AaronXu07/2023-WRO-Future-Engineers-Competition/v-photos/RightSideInternalComponents.jpg

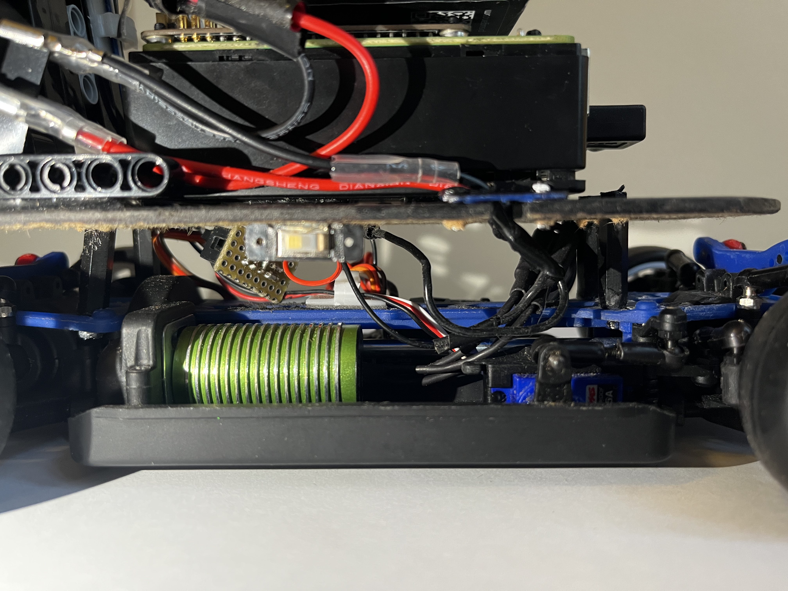
v-photos/RightSideInternalComponents.jpg
