AaronXu07/2023-WRO-Future-Engineers-Competition/v-photos/LeftSideInternalComponents.jpg

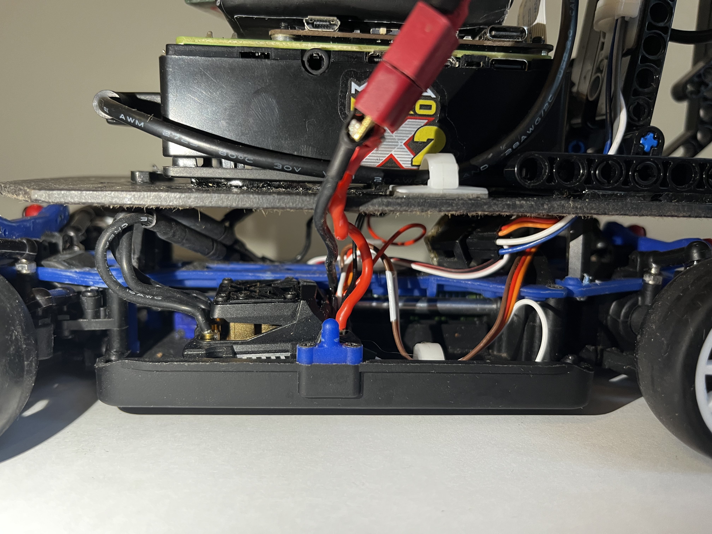
v-photos/LeftSideInternalComponents.jpg
