AaronXu07/2023-WRO-Future-Engineers-Competition/schemes/FutureEngineersWRO2023Schematic.png

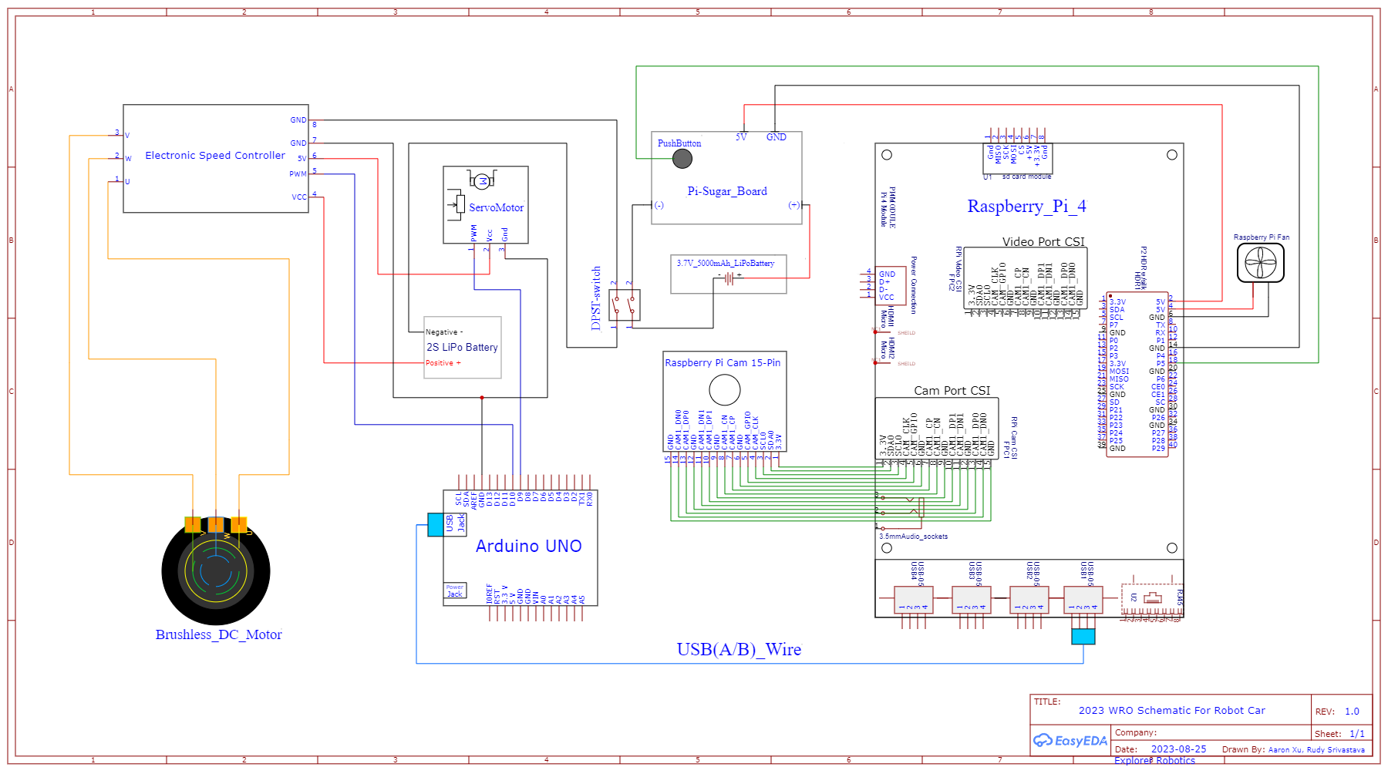
schemes/FutureEngineersWRO2023Schematic.png
