AaronXu07/2023-WRO-Future-Engineers-Competition/t-photos/OfficialTeamPhoto.jpg

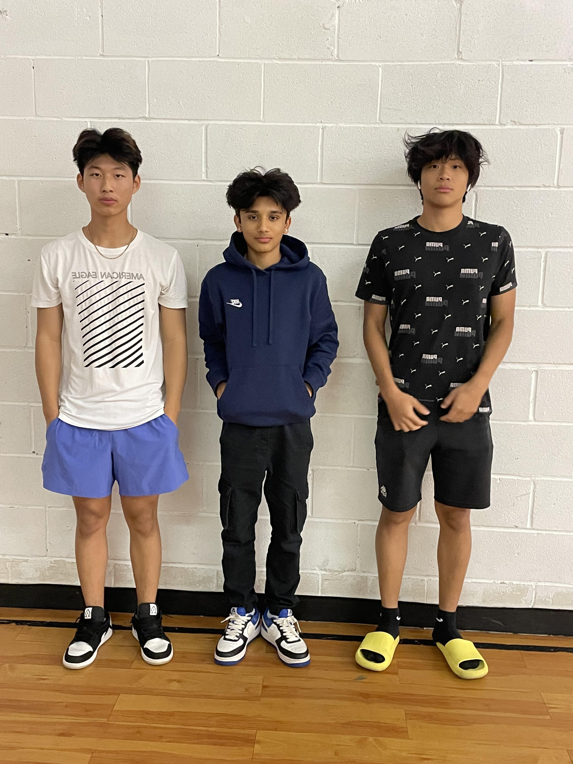
t-photos/OfficialTeamPhoto.jpg
