AaronXu07/2023-WRO-Future-Engineers-Competition/t-photos/SillyPic.jpg

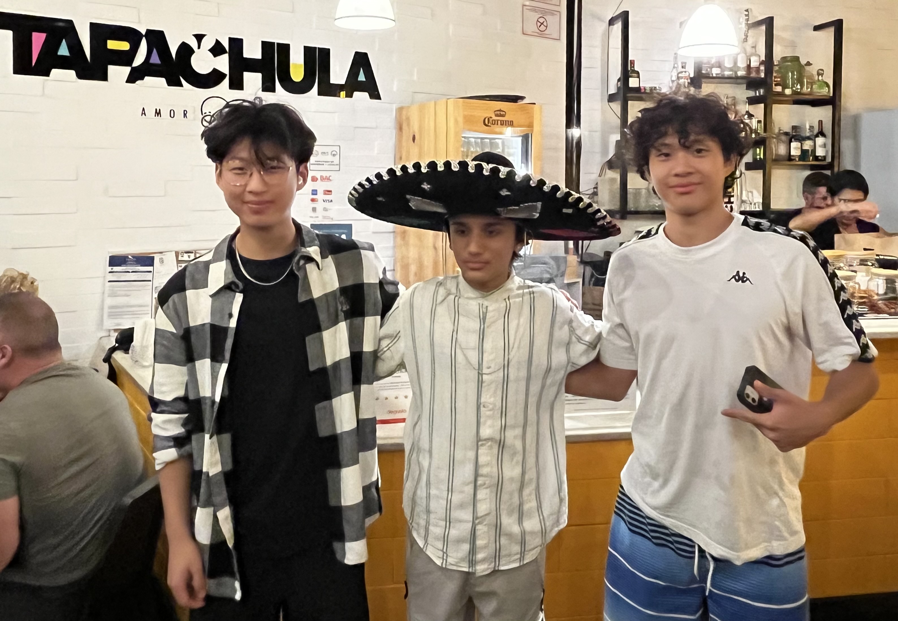
t-photos/SillyPic.jpg
