AaronXu07/2023-WRO-Future-Engineers-Competition/v-photos/Model2BottomView.jpg

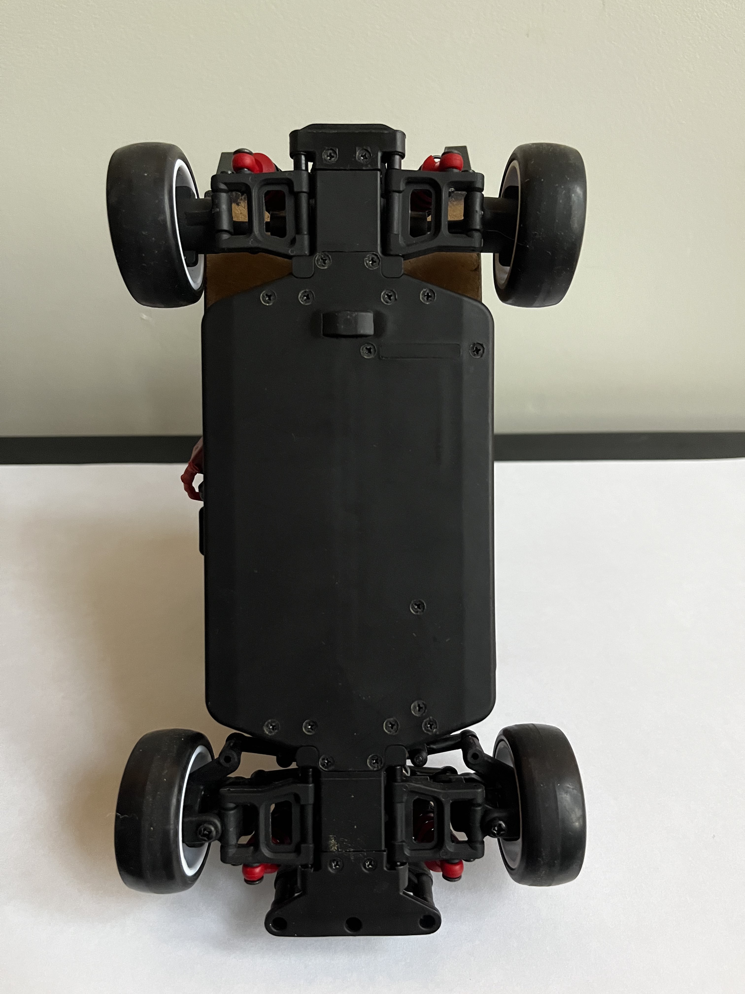
v-photos/Model2BottomView.jpg
