AaronXu07/2023-WRO-Future-Engineers-Competition/v-photos/Model2FrontView.jpg

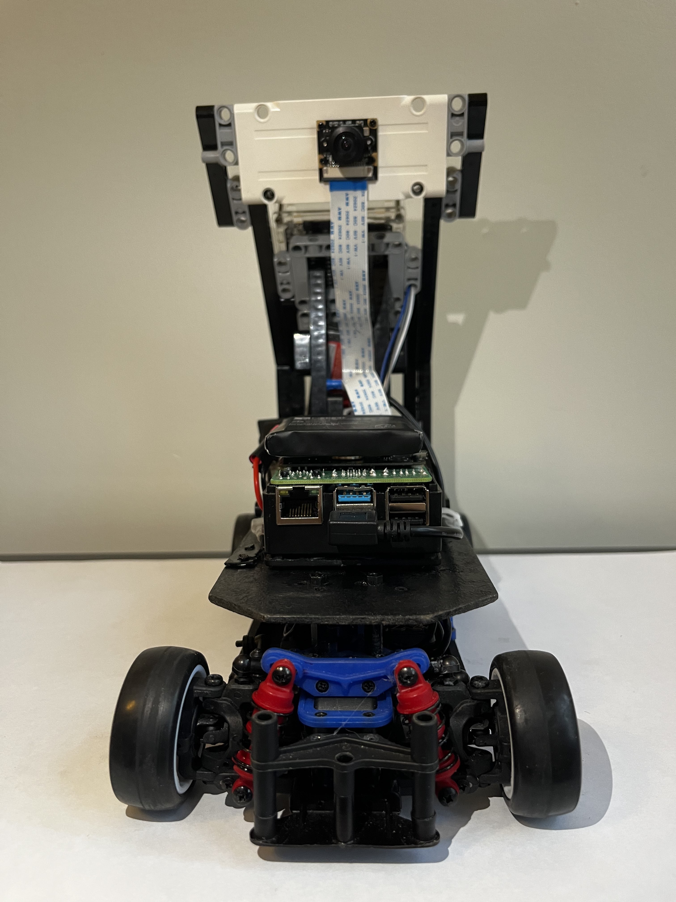
v-photos/Model2FrontView.jpg
