AaronXu07/2023-WRO-Future-Engineers-Competition/v-photos/Model2LeftView.jpg

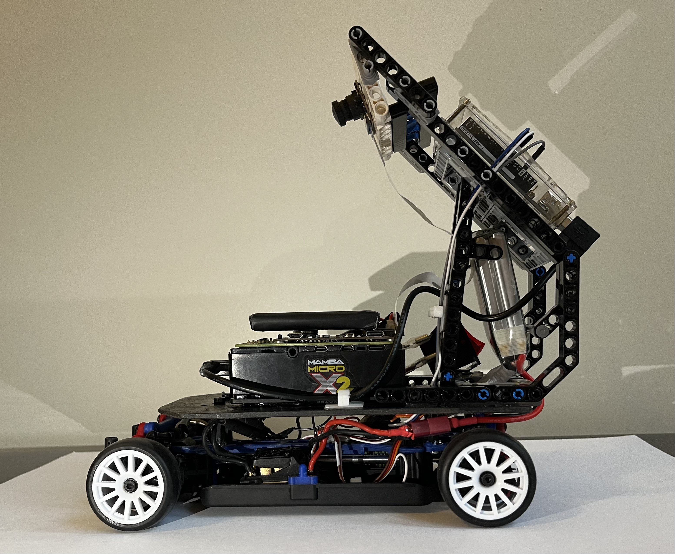
v-photos/Model2LeftView.jpg
