AaronXu07/2023-WRO-Future-Engineers-Competition/v-photos/Model2TopView.jpg

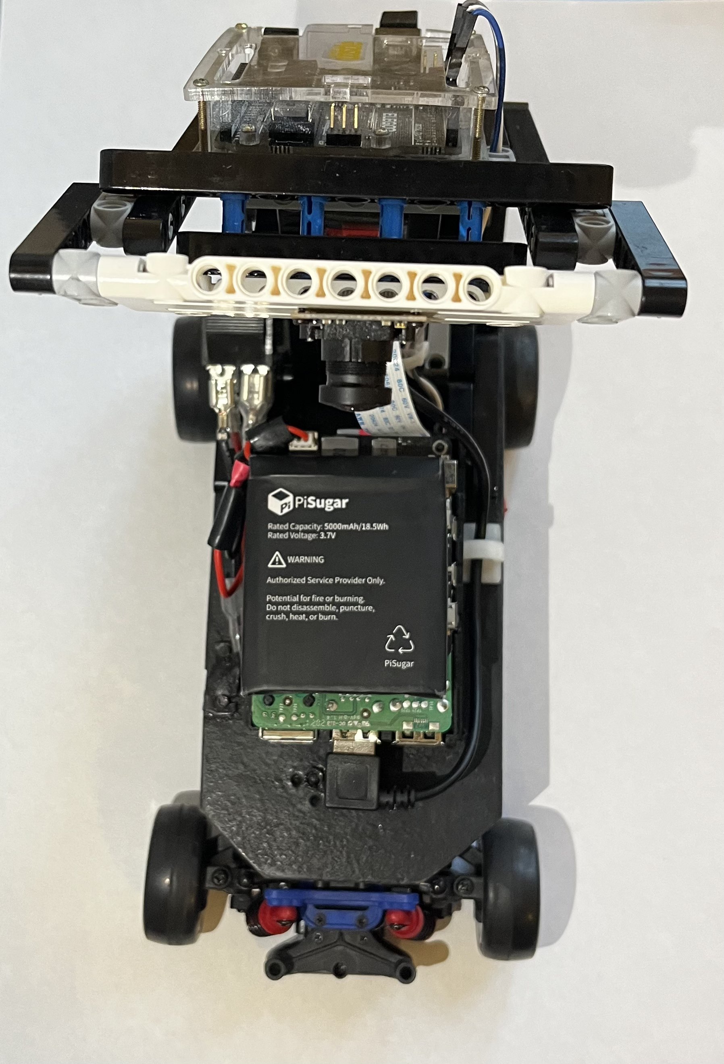
v-photos/Model2TopView.jpg
