AaronXu07/2023-WRO-Future-Engineers-Competition/v-photos/ModelComparison.jpg

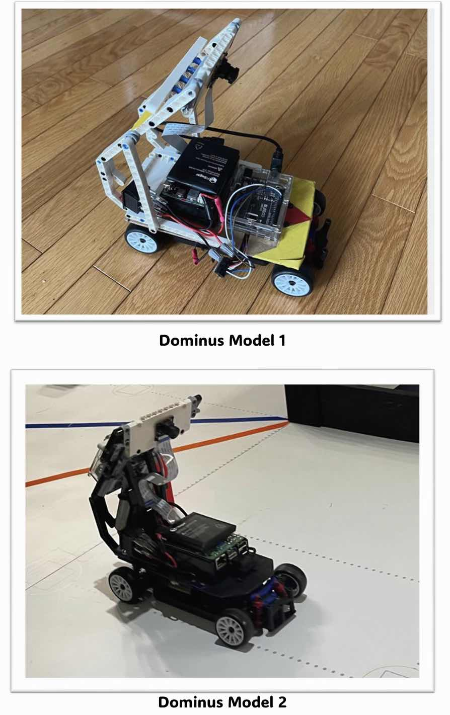
v-photos/ModelComparison.jpg
