AaronXu07/2023-WRO-Future-Engineers-Competition/(commit log)

2023-07-30 Initial Commit
    Arduino and Raspberry Pi Open Challenge basic completion Initial Commit
2023-08-06 fixed bugs found with extreme cases
    [OpenChallenge.py]
2023-08-26 commit schematic diagram
2023-08-26 updated schematic diagram
2023-09-04 Update README.md DPST switch link
2023-09-10 Update Process to build to Raspberry Pi and Arduino README.md
2023-09-28 Updated Arduino Code for New Motor
    Original code caused a glitch that runs the car forward from startup, added a break command to prevent this.
    [ArduinoWRO2023Code.ino]
2023-10-09 fixed bugs in arduino code
    Fixed motor arming process and an error that caused the car to run full throttle before the raspberry pi code booted up
    [ArduinoWRO2023Code.ino]
2023-10-09 Added new motor for model 2 into parts list
2023-10-12 Improved Code for New Motor
    Includes improvements for both obstacle challenge and open challenge
2023-10-15 Fixed 3 Point Turn In Obstacle Challenge Code
    [ObstacleChallenge.py]
2023-10-23 Added Dominus model 2 changes - new, skinnier camera mount
2023-10-24 Model 2 motor
2023-10-27 Added Ratio Feature
    Ratio feature was added to see the ratio of the contour area to the surrounding contour rectangle area. This allows the code to avoid detecting the blue line as a wall.
    [OpenChallenge.py]
2023-10-29 Added "ratio" to prevent false detections
    [ObstacleChallenge.py]
